monokuchi/direct-digital-synthesis/README.md

# direct-digital-synthesis
Implements a simple signal generator using the direct digital synthesis (DDS) technique on a ARM7 core based processor
