monokuchi/direct-digital-synthesis/pcb/direct-digital-synthesis.kicad_pcb

## KiCad design pcb/direct-digital-synthesis.kicad_pcb (2025-02-05)

Schematic: direct-digital-synthesis.kicad_sch

Parts:
C1, C25, C26, C27, C32, C37, C41, C42, C44, C45, C46, C54, C55, C64, C65, C70: 10u; C_0805_2012Metric
C2, C3, C4, C5, C7, C8, C9, C10, C11, C12, C13, C14, C16, C17, C19, C21, C22, C29, C30, C33, C34, C36, C56, C57, C58, C61, C62, C66, C69: 1u; C_0603_1608Metric
C6, C15, C23, C24, C28, C31, C35, C39, C48, C49, C52, C53, C63, C67, C68, C73, C74, C75, C76, C77, C78, C79, C80, C81, C82: 100n; C_0603_1608Metric
C18, C20: 2u2; C_0603_1608Metric
C38, C40: 10n; C_0603_1608Metric
C43: 20p; C_0603_1608Metric
C47: 4p7; C_0603_1608Metric
C50, C51: 22u; C_0805_2012Metric
C59, C71: 220p; C_0603_1608Metric
C60, C72: 470p; C_0603_1608Metric
D1: VCAN16A2-03GHE3-08; SOT65P230X110-3N; Manufacturer_Part_Number VCAN16A2-03GHE3-08; Mouser Part Number 78-VCAN16A203GHE3-08
FID1, FID2, FID3, FID4, FID5, FID6: Fiducial; Fiducial_1mm_Mask2mm
FID7: Fiducial; Fiducial_0.5mm_Mask1mm
H1, H2, H3, H4: MountingHole_Pad; MountingHole_4.3mm_M4_Pad_Via
IC1: IS42S16160J-7TLI; SOP80P1176X120-54N; Manufacturer_Part_Number IS42S16160J-7TLI; Mouser Part Number 870-IS42S16160J-7TLI
J1: TagConnect_TC2030; Tag-Connect_TC2030-IDC-FP_2x03_P1.27mm_Vertical
J2: Barrel_Jack_Switch; BarrelJack_Horizontal
J3: MEM2061-01-188-00-A; MEM20610118800A; Manufacturer_Part_Number MEM2061-01-188-00-A; Mouser Part Number 640-MEM20610118800A
J4: BNC_Connector; SMA_Molex_73251-1153_EdgeMount_Horizontal
J5: Conn_01x07_Socket; PinSocket_1x07_P2.54mm_Vertical
JP1, JP2, JP3, JP4, JP5: ME-100
L1: 6u8; ASPIAIG-F6060
LED1: IN-S66TBTRGB; INS66TBTRGB; Manufacturer_Part_Number IN-S66TBTRGB; Mouser Part Number 743-IN-S66TBTRGB
Q1: PMPB27EPZ; DFN-2020MD-6; Mouser Part Number 771-PMPB27EPZ
R1, R2, R3, R4, R5, R6, R7, R8, R9, R10, R11, R12, R13, R14, R15, R16, R17, R18, R19, R20, R21, R22, R23, R24, R25, R26, R27, R28, R29, R30, R31, R32, R33, R44, R45, R46, R47, R48, R49, R50, R51, R52, R53, R54, R55, R56, R57, R58, R59, R60, R61, R62, R63, R64, R71, R72, R73, R74, R75, R76, R77, R78, R79, R80, R81, R82, R83, R84, R85, R86, R87, R88: 22R; R_0603_1608Metric
R34, R42, R91, R93, R94, R95, R96: 10k; R_0603_1608Metric
R35, R38, R40: 100k; R_0603_1608Metric
R36: 43k2; R_0603_1608Metric
R37, R39: 909k; R_0603_1608Metric
R41, R43: 20k; R_0603_1608Metric
R65, R89: 59R; R_0603_1608Metric
R66, R90: 40R2; R_0603_1608Metric
R67, R68, R69: 100R; R_0603_1608Metric
R70, R92: 50k; R_0603_1608Metric
S1: L102021ML04Q; PARTREV N/A
SW1, SW2: SW_Push; SW_PUSH_6mm
TP1, TP2, TP3, TP4, TP5, TP6, TP7, TP8, TP9, TP10, TP11, TP12, TP13, TP14, TP15, TP16: GND; TestPoint_Keystone_5000-5004_Miniature
TP17: MCU_NRST; TestPoint_Keystone_5000-5004_Miniature
TP18: POWER_+15V; TestPoint_Keystone_5000-5004_Miniature
TP19: POWER_+10V; TestPoint_Keystone_5000-5004_Miniature
TP20: POWER_-12V; TestPoint_Keystone_5000-5004_Miniature
TP21: POWER_+12V; TestPoint_Keystone_5000-5004_Miniature
TP22: POWER_+3V3; TestPoint_Keystone_5000-5004_Miniature
U1: STM32H750IBT6; LQFP-176_24x24mm_P0.5mm
U2, U3: PCHCS541QWRKSRQ1; RKS0020B_VQFN_TEX-M
U4: AD5445YCPZ; CP_20_1_ADI-M
U5: LTC3260EDE-PBF; DFN-14_DE_LIT-M
U6: REF5010AID; D8-M
U7: LMR36015FBRNXR; RNX0012B
U8, U9: AD8066ARZ-R7; R_8_ADI-M
U10: PEC12R-3225F-S0024; PEC12R3225FS0024; Manufacturer_Part_Number PEC12R-3225F-S0024; Mouser Part Number 652-PEC12R3225FS0024
U11: MCP45HV51-ST; TSSOP-14_4.4x5mm_P0.65mm
U12: TLV07IDR; DGK0008A_N
Y1: ECS-2520MVQ-240-BS-TR; ECS2520MVQ240BSTR; Manufacturer_Part_Number ECS-2520MVQ-240-BS-TR

Connections:
+3.3V: C1.1, C2.1, C3.1, C4.1, C5.1, C6.1, C7.1, C8.1, C9.1, C10.1, C11.1, C12.1, C13.1, C14.1, C16.1, C17.1, C19.1, C21.1, C22.1, C23.1, C24.1, C27.1, C29.1, C53.1, C54.1, C55.1, C56.1, C57.1, C58.1, C61.1, C62.1, C66.1, C69.1, C70.1, C73.2, C76.1, IC1.1 (VDD_1), IC1.3 (VDDQ_1), IC1.9 (VDDQ_2), IC1.14 (VDD_2), IC1.27 (VDD_3), IC1.43 (VDDQ_3), IC1.49 (VDDQ_4), J1.1 (VCC), J3.P4 (VDD), J5.1, JP5.2 (B), LED1.1 (COM+), R70.2, R92.2, R93.2, R94.2, U1.6 (VBAT), U1.15 (VDD), U1.23 (VDD), U1.36 (VDD), U1.38 (VREF+), U1.39 (VDDA), U1.49 (VDD), U1.62 (VDD), U1.72 (VDD), U1.82 (VDD), U1.91 (VDD), U1.103 (VDD), U1.114 (VDD33_USB), U1.127 (VDD), U1.136 (VDD), U1.149 (VDD), U1.159 (VDD), U1.171 (PDR_ON), U1.172 (VDD), U2.20 (VCC), U3.20 (VCC), U4.16 (VDD), U11.1 (VL), Y1.4 (VDD)
+12V: C44.1, C48.1, C64.1, C67.1, C78.1, C82.1, JP4.2 (B), U8.8 (V+), U9.8 (V+), U11.14 (V+), U12.7 (V+)
+15V: C35.1, D1.1, J2.1, Q1.4 (S), Q1.8 (S), R34.1
-12V: C45.2, C49.2, C65.2, C68.2, C77.2, JP3.2 (B), U8.4 (V-), U9.4 (V-), U11.10 (V-)
/CHGPMP_+BYP: C40.1, U5.14 (BYP+)
/CHGPMP_+C: C30.1, U5.8 (C+)
/CHGPMP_+LDO: C46.1, JP4.1 (A), R39.1, TP21.1, U5.10 (LDO+)
/CHGPMP_-BYP: C38.1, U5.3 (BYP-)
/CHGPMP_-C: C30.2, U5.7 (C-)
/CHGPMP_-LDO: C42.1, JP3.1 (A), R37.1, TP20.1, U5.5 (LDO-)
/CHGPMP_VOUT: C37.1, U5.6 (VOUT)
/DAC.DB0: R33.2, U4.13 (DB0)
/DAC.DB1: R32.2, U4.12 (DB1)
/DAC.DB2: R31.2, U4.11 (DB2)
/DAC.DB3: R30.2, U4.10 (DB3)
/DAC.DB4: R29.2, U4.9 (DB4)
/DAC.DB5: R28.2, U4.8 (DB5)
/DAC.DB6: R27.2, U4.7 (DB6)
/DAC.DB7: R26.2, U4.6 (DB7)
/DAC.DB8: R25.2, U4.5 (DB8)
/DAC.DB9: R24.2, U4.4 (DB9)
/DAC.DB10: R23.2, U4.3 (DB10)
/DAC.DB11: R22.2, U4.2 (DB11)
/DAC_IOUT1: C47.2, U4.19 (IOUT1), U8.2 (IN-)
/DAC_NCS: R21.2, U4.14 (CS*)
/DAC_RFB: C47.1, R42.1, U4.18 (RFB), U8.1
/DISP_CLK: J5.4, R19.2
/DISP_CS: J5.3, U1.50 (PA4)
/DISP_DC: J5.5, U1.52 (PA6)
/DISP_DIN: J5.6, U1.53 (PA7)
/DISP_NRST: J5.7, U1.54 (PC4)
/DPOT_NSHDN: U1.153 (PG10), U11.8 (~SHDN)
/DPOT_P0W: U11.12 (P0W), U12.3 (IN+)
/DPOT_SCL: U1.164 (PB6), U11.2 (SCL)
/DPOT_SDA: U1.165 (PB7), U11.4 (SDA)
/MCU_DAC.DB0: R6.2, U3.9 (A8)
/MCU_DAC.DB1: R7.2, U3.8 (A7)
/MCU_DAC.DB2: R8.2, U3.7 (A6)
/MCU_DAC.DB3: R9.2, U3.6 (A5)
/MCU_DAC.DB4: R10.2, U3.5 (A4)
/MCU_DAC.DB5: R11.2, U3.4 (A3)
/MCU_DAC.DB6: R12.2, U3.3 (A2)
/MCU_DAC.DB7: R13.2, U3.2 (A1)
/MCU_DAC.DB8: R14.2, U2.9 (A8)
/MCU_DAC.DB9: R15.2, U2.8 (A7)
/MCU_DAC.DB10: R16.2, U2.7 (A6)
/MCU_DAC.DB11: R17.2, U2.6 (A5)
/MCU_DAC_NCS: R18.2, U2.2 (A1)
/MCU_LED_B: R69.2, U1.88 (PH11)
/MCU_LED_G: R68.2, U1.87 (PH10)
/MCU_LED_R: R67.2, U1.86 (PH9)
/MCU_NRST: C15.1, R1.2, TP17.1, U1.31 (NRST)
/MCU_OSC_IN: R5.2, U1.29 (PH0)
/MCU_SWCLK: R2.2, U1.137 (PA14)
/MCU_SWDIO: R3.2, U1.124 (PA13)
/MCU_SWO: R4.2, U1.161 (PB3)
/OPAMP_FILT_VOUT: C72.2, J4.1 (In), U9.6 (IN-), U9.7
/OPAMP_GAIN_VOUT: R43.2, R65.1, U8.7
/OPAMP_VREF: C36.1, R41.1, U4.17 (VREF), U12.2 (IN-), U12.6
/PMOS_DRAIN: D1.2, JP1.1 (A), Q1.1 (D), Q1.2 (D), Q1.5 (D), Q1.6 (D), Q1.7 (D), TP18.1
/POWER_SWITCH_+15V: C25.1, C26.1, C28.2, C31.2, C32.1, JP1.2 (B), U5.1 (EN+), U5.9 (VIN), U5.11 (EN-), U6.2 (VIN), U7.2 (VIN), U7.9 (EN), U7.10 (VIN)
/SDRAM.A0: R44.1, U1.16 (PF0)
/SDRAM.A1: R45.1, U1.17 (PF1)
/SDRAM.A2: R46.1, U1.18 (PF2)
/SDRAM.A3: R47.1, U1.19 (PF3)
/SDRAM.A4: R48.1, U1.20 (PF4)
/SDRAM.A5: R49.1, U1.21 (PF5)
/SDRAM.A6: R50.1, U1.60 (PF12)
/SDRAM.A7: R51.1, U1.63 (PF13)
/SDRAM.A8: R52.1, U1.64 (PF14)
/SDRAM.A9: R53.1, U1.65 (PF15)
/SDRAM.A10: R54.1, U1.66 (PG0)
/SDRAM.A11: R55.1, U1.67 (PG1)
/SDRAM.A12: R56.1, U1.106 (PG2)
/SDRAM.BA0: R57.1, U1.108 (PG4)
/SDRAM.BA1: R58.1, U1.109 (PG5)
/SDRAM.CKE: R60.1, U1.35 (PC3_C)
/SDRAM.CLK: R59.1, U1.112 (PG8)
/SDRAM.DQ0: R71.1, U1.104 (PD14)
/SDRAM.DQ1: R72.1, U1.105 (PD15)
/SDRAM.DQ2: R73.1, U1.142 (PD0)
/SDRAM.DQ3: R74.1, U1.143 (PD1)
/SDRAM.DQ4: R75.1, U1.68 (PE7)
/SDRAM.DQ5: R76.1, U1.69 (PE8)
/SDRAM.DQ6: R77.1, U1.70 (PE9)
/SDRAM.DQ7: R78.1, U1.73 (PE10)
/SDRAM.DQ8: R79.1, U1.74 (PE11)
/SDRAM.DQ9: R80.1, U1.75 (PE12)
/SDRAM.DQ10: R81.1, U1.76 (PE13)
/SDRAM.DQ11: R82.1, U1.77 (PE14)
/SDRAM.DQ12: R83.1, U1.78 (PE15)
/SDRAM.DQ13: R84.1, U1.96 (PD8)
/SDRAM.DQ14: R85.1, U1.97 (PD9)
/SDRAM.DQ15: R86.1, U1.98 (PD10)
/SDRAM.DQMH: R88.1, U1.170 (PE1)
/SDRAM.DQML: R87.1, U1.169 (PE0)
/SDRAM.NCAS: R62.1, U1.160 (PG15)
/SDRAM.NCS: R64.1, U1.34 (PC2_C)
/SDRAM.NRAS: R61.1, U1.59 (PF11)
/SDRAM.NWE: R63.1, U1.32 (PC0)
/SD_CD: C63.1, J3.CD1 (CARD_DETECT_1), R70.1, U1.145 (PD3)
/SD_CLK: J3.P5 (CLK), R20.2
/SD_CMD: J3.P3 (CMD), U1.144 (PD2)
/SD_DAT0: J3.P7 (DAT0), U1.117 (PC8)
/SD_DAT1: J3.P8 (DAT1), U1.118 (PC9)
/SD_DAT2: J3.P1 (DAT2), U1.139 (PC10)
/SD_DAT3: J3.P2 (CD/DAT3), U1.140 (PC11)
/SMPS_BST: C39.1, U7.4 (BST)
/SMPS_FB: C43.1, R35.2, R36.1, U7.7 (FB)
/SMPS_SW: C39.2, L1.1, U7.3 (NC), U7.12 (SW)
/SMPS_VCC: C33.1, U7.5 (VCC)
/SMPS_VOUT: C43.2, C50.1, C51.1, C52.2, JP5.1 (A), L1.2, R35.1, TP22.1
/UI_ENC_A: C80.1, R95.2, U1.40 (PA0)
/UI_ENC_B: C81.1, R96.2, U1.41 (PA1)
/UI_ENC_SW: C74.1, R91.1, U1.43 (PH2)
/UI_SW_A: C75.1, SW1.2, U1.45 (PH4)
/UI_SW_B: C79.1, SW2.2, U1.46 (PH5)
/VREF_+10V: JP2.2 (B), U11.13 (P0A)
GND: C1.2, C2.2, C3.2, C4.2, C5.2, C6.2, C7.2, C8.2, C9.2, C10.2, C11.2, C12.2, C13.2, C14.2, C15.2, C16.2, C17.2, C18.2, C19.2, C20.2, C21.2, C22.2, C23.2, C24.2, C25.2, C26.2, C27.2, C28.1, C29.2, C31.1, C32.2, C33.2, C34.2, C36.2, C37.2, C38.2, C40.2, C41.2, C42.2, C44.2, C45.1, C46.2, C48.2, C49.1, C50.2, C51.2, C52.1, C53.2, C54.2, C55.2, C56.2, C57.2, C58.2, C59.2, C61.2, C62.2, C63.2, C64.2, C65.1, C66.2, C67.2, C68.1, C69.2, C70.2, C71.2, C73.1, C74.2, C75.2, C76.2, C77.1, C78.2, C79.2, C80.2, C81.2, C82.2, D1.3, H1.1, H2.1, H3.1, H4.1, IC1.6 (VSSQ_1), IC1.12 (VSSQ_2), IC1.28 (VSS_1), IC1.41 (VSS_2), IC1.46 (VSSQ_3), IC1.52 (VSSQ_4), IC1.54 (VSS_3), J1.5 (GND), J2.2, J3.CD2 (CARD_DETECT_2), J3.G1 (GND_1), J3.G2 (GND_2), J3.P6 (VSS), J4.2 (Ext), J5.2, R36.2, R38.2, R40.2, S1.3, SW1.1, SW2.1, TP1.1, TP2.1, TP3.1, TP4.1, TP5.1, TP6.1, TP7.1, TP8.1, TP9.1, TP10.1, TP11.1, TP12.1, TP13.1, TP14.1, TP15.1, TP16.1, U1.14 (VSS), U1.22 (VSS), U1.37 (VSSA), U1.48 (VSS), U1.61 (VSS), U1.71 (VSS), U1.90 (VSS), U1.102 (VSS), U1.113 (VSS), U1.126 (VSS), U1.135 (VSS), U1.148 (VSS), U1.158 (VSS), U1.166 (BOOT0), U2.1 (*OE1), U2.3 (A2), U2.4 (A3), U2.5 (A4), U2.10 (GND), U2.19 (*OE2), U2.21 (GND), U3.1 (*OE1), U3.10 (GND), U3.19 (*OE2), U3.21 (GND), U4.1 (GND), U4.15 (R/W*), U4.20 (IOUT2), U4.21 (EP), U5.2 (RT), U5.12 (MODE), U5.15 (EPAD), U6.4 (GND), U7.1 (PGND), U7.6 (AGND), U7.8 (PG), U7.11 (PGND), U8.3 (IN+), U8.5 (IN+), U10.2, U10.C1, U11.3 (A1), U11.5 (A0), U11.6 (~WLAT), U11.9 (DGND), U11.11 (P0B), U12.4 (V-), Y1.2 (GND)
unnamed: C18.1, U1.81 (VCAP)
unnamed: C20.1, U1.125 (VCAP)
unnamed: C60.1, R65.2, R66.1
unnamed: C72.1, R89.2, R90.1
unnamed: IC1.23 (A0), R44.2
unnamed: IC1.24 (A1), R45.2
unnamed: IC1.25 (A2), R46.2
unnamed: IC1.26 (A3), R47.2
unnamed: IC1.29 (A4), R48.2
unnamed: IC1.30 (A5), R49.2
unnamed: IC1.31 (A6), R50.2
unnamed: IC1.32 (A7), R51.2
unnamed: IC1.33 (A8), R52.2
unnamed: IC1.34 (A9), R53.2
unnamed: IC1.22 (A10), R54.2
unnamed: IC1.35 (A11), R55.2
unnamed: IC1.36 (A12), R56.2
unnamed: IC1.20 (BA0), R57.2
unnamed: IC1.21 (BA1), R58.2
unnamed: IC1.37 (CKE), R60.2
unnamed: IC1.38 (CLK), R59.2
unnamed: IC1.2 (DQ0), R71.2
unnamed: IC1.4 (DQ1), R72.2
unnamed: IC1.5 (DQ2), R73.2
unnamed: IC1.7 (DQ3), R74.2
unnamed: IC1.8 (DQ4), R75.2
unnamed: IC1.10 (DQ5), R76.2
unnamed: IC1.11 (DQ6), R77.2
unnamed: IC1.13 (DQ7), R78.2
unnamed: IC1.42 (DQ8), R79.2
unnamed: IC1.44 (DQ9), R80.2
unnamed: IC1.45 (DQ10), R81.2
unnamed: IC1.47 (DQ11), R82.2
unnamed: IC1.48 (DQ12), R83.2
unnamed: IC1.50 (DQ13), R84.2
unnamed: IC1.51 (DQ14), R85.2
unnamed: IC1.53 (DQ15), R86.2
unnamed: IC1.39 (DQMH), R88.2
unnamed: IC1.15 (DQML), R87.2
unnamed: IC1.17 (~CAS), R62.2
unnamed: IC1.19 (~CS), R64.2
unnamed: IC1.18 (~RAS), R61.2
unnamed: IC1.16 (~WE), R63.2
unnamed: J1.4 (SWCLK), R2.1
unnamed: J1.2 (SWDIO), R3.1
unnamed: J1.6 (SWO), R4.1
unnamed: J1.3 (~RESET), R1.1
unnamed: C41.1, JP2.1 (A), TP19.1, U6.6 (VOUT)
unnamed: LED1.3 (K_BLUE), R69.1
unnamed: LED1.4 (K_GREEN), R68.1
unnamed: LED1.2 (K_RED), R67.1
unnamed: C35.2, Q1.3 (G), R34.2, S1.2
unnamed: R91.2, R92.1, U10.1
unnamed: R93.1, R95.1, U10.A1
unnamed: R94.1, R96.1, U10.B1
unnamed: R19.1, U1.51 (PA5)
unnamed: R20.1, U1.141 (PC12)
unnamed: R18.1, U1.25 (PF7)
unnamed: R6.1, U1.131 (PI0)
unnamed: R7.1, U1.132 (PI1)
unnamed: R8.1, U1.133 (PI2)
unnamed: R9.1, U1.134 (PI3)
unnamed: R10.1, U1.173 (PI4)
unnamed: R11.1, U1.174 (PI5)
unnamed: R12.1, U1.175 (PI6)
unnamed: R13.1, U1.176 (PI7)
unnamed: R14.1, U1.7 (PI8)
unnamed: R15.1, U1.11 (PI9)
unnamed: R16.1, U1.12 (PI10)
unnamed: R17.1, U1.13 (PI11)
unnamed: R21.1, U2.18 (Y1)
unnamed: R22.1, U2.14 (Y5)
unnamed: R23.1, U2.13 (Y6)
unnamed: R24.1, U2.12 (Y7)
unnamed: R25.1, U2.11 (Y8)
unnamed: R26.1, U3.18 (Y1)
unnamed: R27.1, U3.17 (Y2)
unnamed: R28.1, U3.16 (Y3)
unnamed: R29.1, U3.15 (Y4)
unnamed: R30.1, U3.14 (Y5)
unnamed: R31.1, U3.13 (Y6)
unnamed: R32.1, U3.12 (Y7)
unnamed: R33.1, U3.11 (Y8)
unnamed: R39.2, R40.1, U5.13 (ADJ+)
unnamed: R37.2, R38.1, U5.4 (ADJ-)
unnamed: C34.1, U6.5 (TRIM/NR)
unnamed: R41.2, R42.2, R43.1, U8.6 (IN-)
unnamed: C59.1, R66.2, U9.3 (IN+)
unnamed: C60.2, R89.1, U9.1, U9.2 (IN-)
unnamed: C71.1, R90.2, U9.5 (IN+)
unnamed: R5.1, Y1.3 (OUTPUT)

Notes on the sheet:
Gain/DC Bias Stage
Push Buttons
Low Pass Filter
Transimpedance Amplifier
Precision Voltage Reference (+10VDC)
Rotary Encoder
Input DC Power Jack w/ Switch
DAC
Schmitt Trigger Buffers
Low Noise Dual Supply Inverting Charge Pump (+-12VDC)
SMPS (+3.3VDC)
Power Switch Requirements: Max Voltage Rating > 15VDC Max Current Rating > 600mA
1/8W rated current limiting resistors
Low Temperature Drift Precision Resistors
I2C Device Address is 0111 100b (Pg 51)
V_{out}=[+V_{ref} to -V_{ref}]
LDO_{vout}=VREF*(1+R1/R2) (For both + and - LDOs) VREF=1.2VDC, R1=909k, R2=100k LDO_{vout}=+-12.108VDC (Pg 10)
Micro SD Card
[Current Budget (3.3V Rail in Amps)] MCU: 0.620 Schmitt Trigger Buffers (x2): 0.0002 DAC: 0.005 Micro SD Card: 0.16 Rotary Encoder: 0.01 RGB LED: 0.06 Display: 0.06 Clock Oscillator: 0.01 SDRAM: 0.12 Total: 1.0452 Amps
Mounting Holes
List of voltages needed: +3.3VDC +12VDC -12VDC
Power Supply IC's already have built in in-rush current management so don't need to have external circuitry to handle sparking Ex (3.3VDC Rail): I_{inrush}=C_{load}*(dV/dt)=75 [uF] * (3.3/4 [ms])~=62 [mA] (4 ms rise time specified on Pg 13)
Low ESR VCAP Capacitors (<100 mOhms)
Display Connector
Place series termination resistors close to the driver output
Maximum Voltage: 16VDC
Output amplifier is meant to drive standard line level audio equipment which usually have a load impedance of ~600 Ohms. So power circuitry needs to be capable of supplying at least I=V/R -> I=10[V]/600[R]=16.67[mA]
OLED Display Resolution is 128x128 and 16 bits per pixel
The 10uF bypass capacitors on LDO+, LDO-, VIN should be low ESR Also make sure to choose max voltage rating of the capacitors high enough to prevent excessive capacitance loss (Pg 7)
Digital Potentiometer
ESR of Vout Bypass Capacitor must be within [1, 1.5] Ohms to ensure ouput stability
TVS Diode Protection
When SD card is inserted SD_CD is high and when SD card is not inserted SD_CD is low
Power
Relying on internal pull up resistors and ESD protection of STM32 MCU SD Clock Running at 40 MHz
Fiducials
Cutoff Frequency: f(-3dB) = 8.33 MHz Gain (Linear): 1 Number of Filter Stages: 2 Total Filter Order: 4 Q=0.72 Total Quiescient Current Draw: 14.8 mA
50 Ohm BNC Connector
Ground Test Points
Bypass Capacitors included to help mitgate noise
SDRAM
Status LED
High Precision 1%, 100VDC, C0G (NP0) Ceramic Capacitors
Control UI
CAS Latency of 2 selected -> Running clock at max, 133 MHz In CubeIDE select SDRAM common clock to 3 clock cycles which then divides the FMC clock running at 240 MHz by 3. Therefore the SDRAM is running at effectively 80 MHz. This falls below the maximum speed limit of the MCU's FMC module which is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
Phase Compensation Capacitor
15VDC, 2A Center Positive
MCU
Place series termination resistors close to the driver output
Clock Oscillator
Unused inputs must be tied either to VCC or GND. Unused outputs must be no connects. (Pg 12)
MCU 24 MHz Clock Oscillator
f(-3dB)=159 Hz
End to End Resistance is 10kOhms
Make sure that PMOS has low R_{DS-on} and enough continuous I_{D} rating to handle total current draw. Also make sure to check maximum V_{gs} rating and see if it can handle -15VDC
RT = GND -> 500kHz Switching Frequency @ 15VDC Input Voltage (Pg 9)
Make sure to use low ESR capactors as it will lower output ripple
V_{out}=[0 to -V_{ref}]
256Mb (16Mx16), 143MHz SDRAM
-> LDO -> 12VDC 15VDC Input -> Inverting Charge Pump Regulator -> -15VDC -> LDO -> -12VDC (Low Noise) -> SMPS -> 3.3VDC
At full white screen pulls about 60mA
Read functionality is essentially disabled since the Schmitt Triggers Buffers are unidirectional. Therefore tie R/~{W} to GND which fixes the DAC mode to be write only.
SWD
V_{out}=[0 to +10VDC]
Match specific trace width and board layer thickness to get 50 Ohm characteristic impedance. JLCPCB provides impedance calculator
Need a fast slew rate op amp for ouput signal since output peak to peak voltage is large. For a sin wave, slew rate=A_{pp}*2π*f so slew rate=20*2π*1MHz=126 V/uS
Tolerances: Resistors -> 1% Capacitors -> 5% Op Amp GBW -> 20% Op Amp: AD8066ARZ
Choose X7R or higher rating. Also, choose maximum voltage rating of at least 2x the input voltage to prevent derating of the effective capacitance
High Precision 0.1%, 10 PPM/C SMD Resistors
1MHz Switching Frequency @ 15VDC Input Voltage

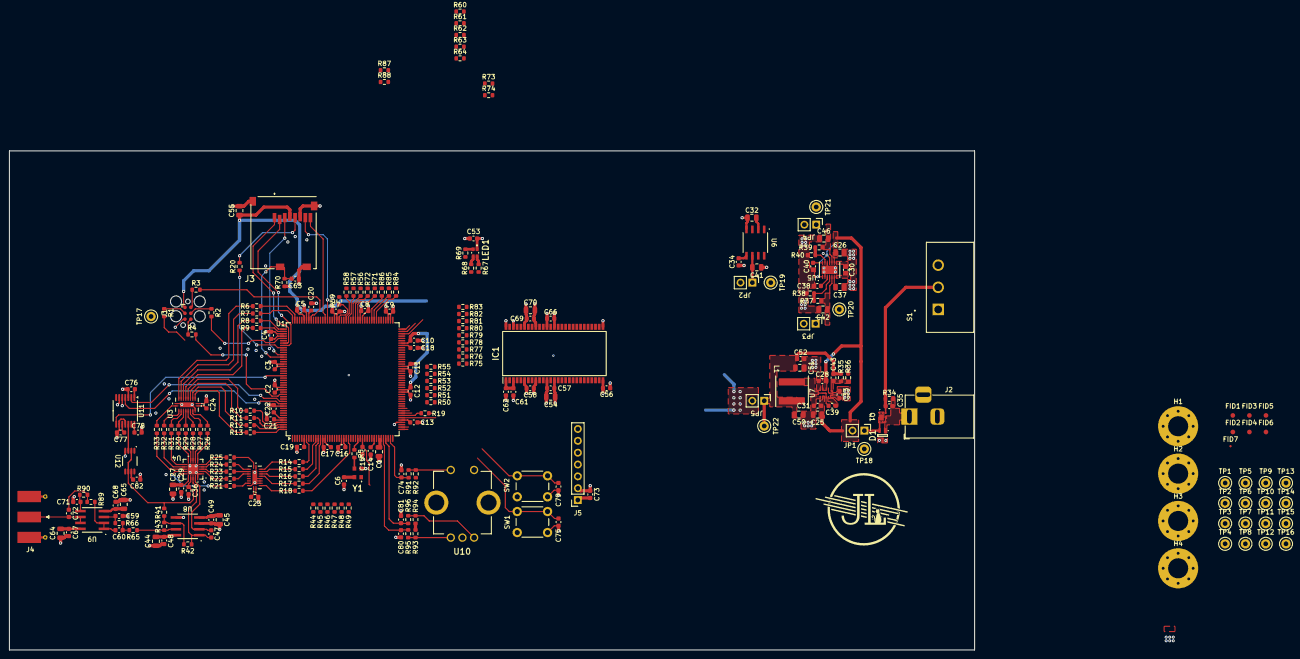
[picture p1: board direct-digital-synthesis.kicad_pcb from above]

Board: 4 copper layers, 206.9 x 107.0 mm, 242 parts (0 on the bottom side), 210 nets.
