monokuchi/direct-digital-synthesis/src/Core/Src/main.c

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
/* Includes ------------------------------------------------------------------*/
#include "main.h"

/* USER CODE BEGIN Includes */
#include "DDS.h"
/* USER CODE END Includes */

/* USER CODE BEGIN PD */
#define DAC_DATA_BUFFER_SIZE 16

#define SDRAM_START_ADDRESS 0xC0000000 // Look at Pg 802 of Reference Manual for memory mapping
#define SDRAM_SIZE 0x2000000 // Number of bytes in the SDRAM
/* USER CODE END PD */


SD_HandleTypeDef hsd1;

TIM_HandleTypeDef htim2;
DMA_HandleTypeDef hdma_tim2_up;

SDRAM_HandleTypeDef hsdram1;

void SystemClock_Config(void);
static void MX_GPIO_Init(void);
static void MX_DMA_Init(void);
static void MX_FMC_Init(void);
static void MX_SDMMC1_SD_Init(void);
static void MX_TIM2_Init(void);
/* USER CODE BEGIN 0 */
void Update_StatusLED(const HAL_StatusTypeDef *status)
{
	// Turn on Status LED indicating that something went wrong
	if (status != HAL_OK)
	{
		HAL_GPIO_WritePin(STATUS_LED_R_GPIO_Port, STATUS_LED_R_Pin, GPIO_PIN_RESET);
	}
	else
	{
		HAL_GPIO_WritePin(STATUS_LED_G_GPIO_Port, STATUS_LED_G_Pin, GPIO_PIN_RESET);
	}
}

HAL_StatusTypeDef SDRAM_Init()
{
	/* Initializes the SDRAM to access read and write operations */

	FMC_SDRAM_CommandTypeDef Command;
	HAL_StatusTypeDef status;

    /* Step 1 and Step 2 already done in HAL_SDRAM_Init() */

    /* Step 3: Configure a clock configuration enable command */
    Command.CommandMode            = FMC_SDRAM_CMD_CLK_ENABLE; /* Set MODE bits to "001" */
    Command.CommandTarget          = FMC_SDRAM_CMD_TARGET_BANK1; /* configure the Target Bank bits */
    Command.AutoRefreshNumber      = 1;
    Command.ModeRegisterDefinition = 0;
    status = HAL_SDRAM_SendCommand(&hsdram1, &Command, 0xfff);
    if (status != HAL_OK) { return status; }

    /* Step 4: Insert 100 us minimum delay - Min HAL Delay is 1ms */
    HAL_Delay(1);

    /* Step 5: Configure a PALL (precharge all) command */
    Command.CommandMode            = FMC_SDRAM_CMD_PALL; /* Set MODE bits to "010" */
    status = HAL_SDRAM_SendCommand(&hsdram1, &Command, 0xfff);
    if (status != HAL_OK) { return status; }

    /* Step 6: Configure an Auto Refresh command */
    Command.CommandMode            = FMC_SDRAM_CMD_AUTOREFRESH_MODE; /* Set MODE bits to "011" */
    Command.AutoRefreshNumber      = 2;
    status = HAL_SDRAM_SendCommand(&hsdram1, &Command, 0xfff);
    if (status != HAL_OK) { return status; }

    /* Step 7: Program the external memory mode register */
    Command.CommandMode            = FMC_SDRAM_CMD_LOAD_MODE;/*set the MODE bits to "100" */
    Command.ModeRegisterDefinition =  (uint32_t)0 | 0<<3 | 2<<4 | 0<<7 | 1<<9;
    status = HAL_SDRAM_SendCommand(&hsdram1, &Command, 0xfff);
    if (status != HAL_OK) { return status; }

    /* Step 8: Set the refresh rate counter - refer to section SDRAM refresh timer register in RM0455 */
    /* Set the device refresh rate
	 * COUNT = [(SDRAM self refresh time / number of row) x  SDRAM CLK] – 20
	   		 = [(64ms/8192) * 80MHz] - 20 = 625 - 20 = 605 */
    status = HAL_SDRAM_ProgramRefreshRate(&hsdram1, 605);

    return status;
}

HAL_StatusTypeDef SDRAM_Read(SDRAM_HandleTypeDef *sdram)
{
	/* Performs a read operation on target SDRAM */
	HAL_StatusTypeDef status;

	return status;
}

HAL_StatusTypeDef SDRAM_Write(SDRAM_HandleTypeDef *sdram)
{
	/* Performs a write operation on target SDRAM */
	HAL_StatusTypeDef status;

	return status;
}

HAL_StatusTypeDef DAC_Init()
{
	/* Starts up the DAC clock and data signals */
	HAL_StatusTypeDef status;


	uint32_t dac_data_buffer[DAC_DATA_BUFFER_SIZE] = {0xFFFF0000, 0x00000001}; // Should toggle the first GPIOI pin on and off if DMA is in circular mode

	/* Prepare the DAC data signal to be sent on clock signal timer event via DMA transfers */
	status = HAL_DMA_Start(&hdma_tim2_up, (uint32_t) dac_data_buffer, (uint32_t) &(GPIOI->BSRR), DAC_DATA_BUFFER_SIZE);
	if (status != HAL_OK) { return status; }

	/* Start up the DAC clock signal */
	status = HAL_TIM_PWM_Start(&htim2, TIM_CHANNEL_2);
	if (status != HAL_OK) { return status; }
	__HAL_TIM_SET_COMPARE(&htim2, TIM_CHANNEL_2, 13); // Set duty cycle of PWM generation to 50%
    TIM2->DIER |= TIM_DIER_UDE; // Enable DMA on timer update event (counter overflow)


	return status;
}

/* USER CODE END 0 */

/**
  * @brief  The application entry point.
  * @retval int
  */
int main(void)
{

  /* MCU Configuration--------------------------------------------------------*/

  /* Reset of all peripherals, Initializes the Flash interface and the Systick. */
  HAL_Init();

  /* Configure the system clock */
  SystemClock_Config();

  /* Initialize all configured peripherals */
  MX_GPIO_Init();
  MX_DMA_Init();
  MX_FMC_Init();
  MX_SDMMC1_SD_Init();
  MX_TIM2_Init();
  /* USER CODE BEGIN 2 */

  if (SDRAM_Init() != HAL_OK) { Update_StatusLED(); } // Prepare the SDRAM for read/write operations

  if (DAC_Init() != HAL_OK) { Update_StatusLED(); } // Prepare the DAC clock and data signals

  /* USER CODE END 2 */

  /* Infinite loop */
  /* USER CODE BEGIN WHILE */
  while (1)
  {
    /* USER CODE END WHILE */

    /* USER CODE BEGIN 3 */
  }
  /* USER CODE END 3 */
}

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
