monokuchi/direct-digital-synthesis/src/direct-digital-synthesis.ioc

Mcu.UserName=STM32H750IBTx
PA1.GPIO_Label=DAC_NCS
PA1.Signal=S_TIM2_CH2
PC0.Signal=FMC_SDNWE
PC10.Signal=SDMMC1_D2
PC11.Signal=SDMMC1_D3
PC12.Signal=SDMMC1_CK
PC2_C.Signal=FMC_SDNE0
PC3_C.Signal=FMC_SDCKE0
PC8.Signal=SDMMC1_D0
PC9.Signal=SDMMC1_D1
PD0.Signal=FMC_D2_DA2
PD1.Signal=FMC_D3_DA3
PD10.Signal=FMC_D15_DA15
PD14.Signal=FMC_D0_DA0
PD15.Signal=FMC_D1_DA1
PD2.Signal=SDMMC1_CMD
PD3.GPIO_Label=SD_NCD
PD3.Signal=GPIO_Input
PD8.Signal=FMC_D13_DA13
PD9.Signal=FMC_D14_DA14
PE0.Signal=FMC_NBL0
PE1.Signal=FMC_NBL1
PE10.Signal=FMC_D7_DA7
PE11.Signal=FMC_D8_DA8
PE12.Signal=FMC_D9_DA9
PE13.Signal=FMC_D10_DA10
PE14.Signal=FMC_D11_DA11
PE15.Signal=FMC_D12_DA12
PE7.Signal=FMC_D4_DA4
PE8.Signal=FMC_D5_DA5
PE9.Signal=FMC_D6_DA6
PF0.Signal=FMC_A0
PF1.Signal=FMC_A1
PF11.Signal=FMC_SDNRAS
PF12.Signal=FMC_A6
PF13.Signal=FMC_A7
PF14.Signal=FMC_A8
PF15.Signal=FMC_A9
PF2.Signal=FMC_A2
PF3.Signal=FMC_A3
PF4.Signal=FMC_A4
PF5.Signal=FMC_A5
PG0.Signal=FMC_A10
PG1.Signal=FMC_A11
PG15.Signal=FMC_SDNCAS
PG2.Signal=FMC_A12
PG4.Signal=FMC_A14_BA0
PG5.Signal=FMC_A15_BA1
PG8.Signal=FMC_SDCLK
PH2.GPIO_Label=STATUS_LED_R
PH2.Signal=GPIO_Output
PH3.GPIO_Label=STATUS_LED_G
PH3.Signal=GPIO_Output
PH4.GPIO_Label=STATUS_LED_B
PH4.Signal=GPIO_Output
PI0.GPIO_Label=DAC_DB0
PI0.Signal=GPIO_Output
PI1.GPIO_Label=DAC_DB1
PI1.Signal=GPIO_Output
PI10.GPIO_Label=DAC_DB10
PI10.Signal=GPIO_Output
PI11.GPIO_Label=DAC_DB11
PI11.Signal=GPIO_Output
PI2.GPIO_Label=DAC_DB2
PI2.Signal=GPIO_Output
PI3.GPIO_Label=DAC_DB3
PI3.Signal=GPIO_Output
PI4.GPIO_Label=DAC_DB4
PI4.Signal=GPIO_Output
PI5.GPIO_Label=DAC_DB5
PI5.Signal=GPIO_Output
PI6.GPIO_Label=DAC_DB6
PI6.Signal=GPIO_Output
PI7.GPIO_Label=DAC_DB7
PI7.Signal=GPIO_Output
PI8.GPIO_Label=DAC_DB8
PI8.Signal=GPIO_Output
PI9.GPIO_Label=DAC_DB9
PI9.Signal=GPIO_Output
