monokuchi/direct-digital-synthesis/src/Core/Inc/main.h

#define DAC_DB8_Pin GPIO_PIN_8
#define DAC_DB8_GPIO_Port GPIOI
#define DAC_DB9_Pin GPIO_PIN_9
#define DAC_DB9_GPIO_Port GPIOI
#define DAC_DB10_Pin GPIO_PIN_10
#define DAC_DB10_GPIO_Port GPIOI
#define DAC_DB11_Pin GPIO_PIN_11
#define DAC_DB11_GPIO_Port GPIOI
#define DAC_NCS_Pin GPIO_PIN_1
#define DAC_NCS_GPIO_Port GPIOA
#define STATUS_LED_R_Pin GPIO_PIN_2
#define STATUS_LED_R_GPIO_Port GPIOH
#define STATUS_LED_G_Pin GPIO_PIN_3
#define STATUS_LED_G_GPIO_Port GPIOH
#define STATUS_LED_B_Pin GPIO_PIN_4
#define STATUS_LED_B_GPIO_Port GPIOH
#define DAC_DB0_Pin GPIO_PIN_0
#define DAC_DB0_GPIO_Port GPIOI
#define DAC_DB1_Pin GPIO_PIN_1
#define DAC_DB1_GPIO_Port GPIOI
#define DAC_DB2_Pin GPIO_PIN_2
#define DAC_DB2_GPIO_Port GPIOI
#define DAC_DB3_Pin GPIO_PIN_3
#define DAC_DB3_GPIO_Port GPIOI
#define SD_NCD_Pin GPIO_PIN_3
#define SD_NCD_GPIO_Port GPIOD
#define DAC_DB4_Pin GPIO_PIN_4
#define DAC_DB4_GPIO_Port GPIOI
#define DAC_DB5_Pin GPIO_PIN_5
#define DAC_DB5_GPIO_Port GPIOI
#define DAC_DB6_Pin GPIO_PIN_6
#define DAC_DB6_GPIO_Port GPIOI
#define DAC_DB7_Pin GPIO_PIN_7
#define DAC_DB7_GPIO_Port GPIOI
