monokuchi/direct-digital-synthesis/(commit log)

2025-01-08 Updated pcb and src
    [direct-digital-synthesis.kicad_pcb, direct-digital-synthesis.kicad_sch]
2025-01-11 pcb update
    [direct-digital-synthesis.kicad_pcb, direct-digital-synthesis.kicad_sch]
2025-01-20 update pcb
    [direct-digital-synthesis.kicad_pcb, direct-digital-synthesis.kicad_sch]
2025-02-05 fixed sdram
    [direct-digital-synthesis.kicad_pcb, direct-digital-synthesis.kicad_sch]
